Sameermd-18/industrial-paint-mixing-controller/hardware/system-overview.jpeg

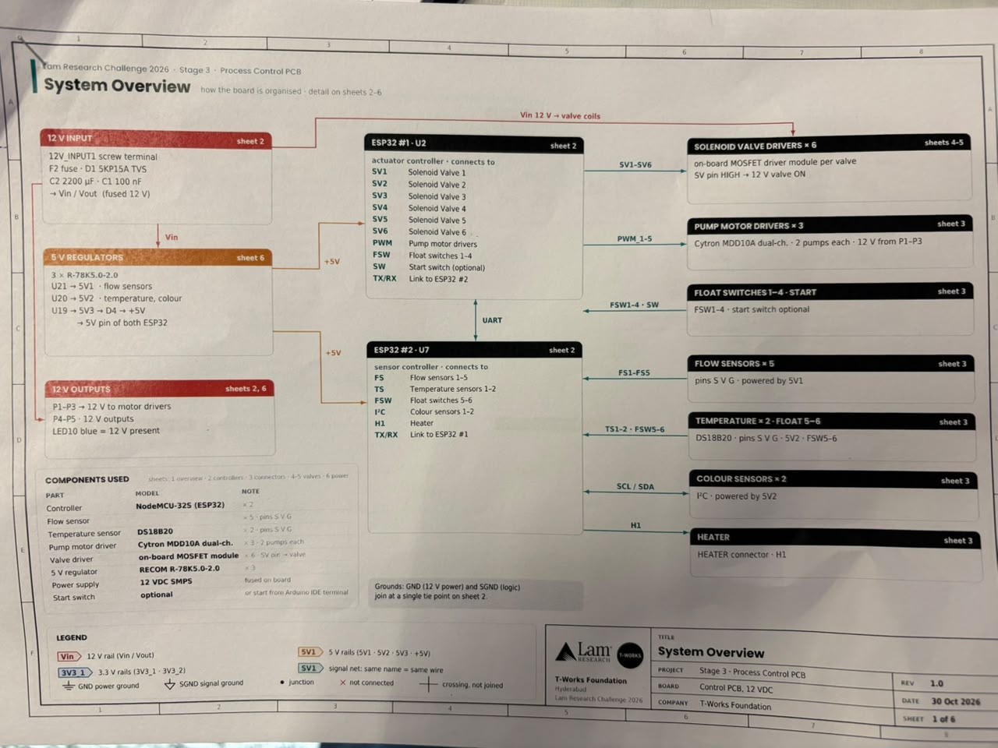
hardware/system-overview.jpeg
