Sameermd-18/industrial-paint-mixing-controller/hardware/solenoid-drivers.jpeg

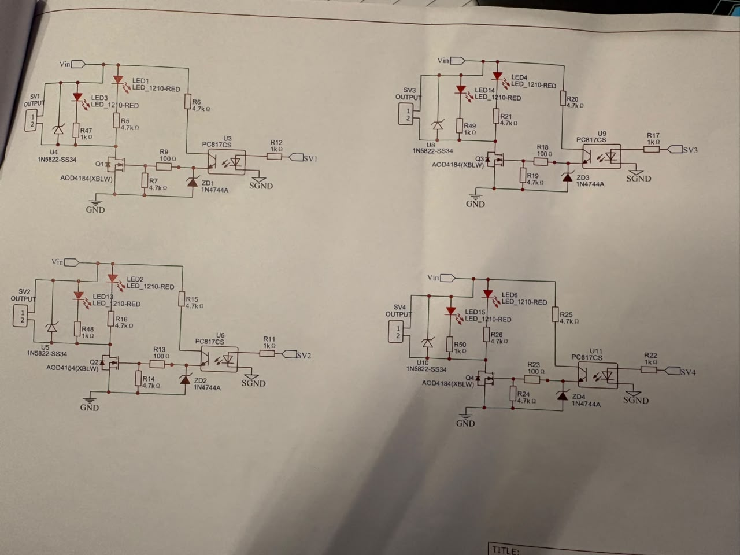
hardware/solenoid-drivers.jpeg
