Sameermd-18/industrial-paint-mixing-controller/hardware/README.md

# Hardware references

These are photographs of the supplied control PCB circuit schematics. They show the board architecture, ESP32 pin mapping, connector signals, and solenoid driver circuits. They are **not** fabrication-ready PCB layout files, Gerbers, or independently verified as-built wiring.

- [System overview](system-overview.jpeg)
- [ESP32 controller pins](esp32-controller-pins.jpeg)
- [Field connectors and flow sensor headers](field-connectors.jpeg)
- [Solenoid driver circuits, SV1–SV4](solenoid-drivers.jpeg)
- [ESP32 controllers and 12 V input (supplied sheet)](esp32-controllers-and-12v-input.jpeg)
- [Alternate controller schematic photograph](alternate-controller-schematic.jpeg)
- [Solenoid driver circuits, SV5–SV6](solenoid-drivers-sv5-sv6.jpeg)
- [5 V regulators and 12 V output connectors](power-regulators-and-12v-outputs.jpeg)
- [Sensor, motor driver, and switch connectors](sensor-and-motor-connectors.jpeg)

For the as-tested pump and valve mappings, use the top-level README and inspect the current U2/U7 sketches. The images are reference documentation only.
