Sameermd-18/industrial-paint-mixing-controller/hardware/alternate-controller-schematic.jpeg

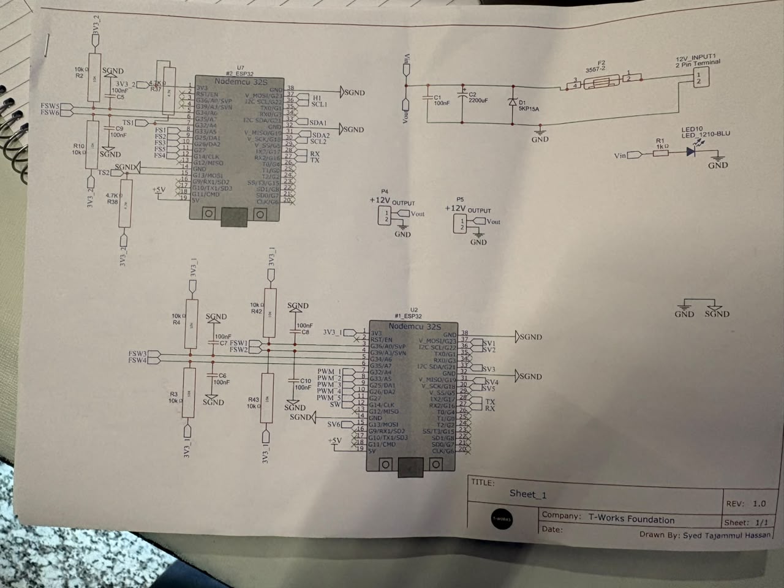
hardware/alternate-controller-schematic.jpeg
