Sameermd-18/industrial-paint-mixing-controller/hardware/esp32-controller-pins.jpeg

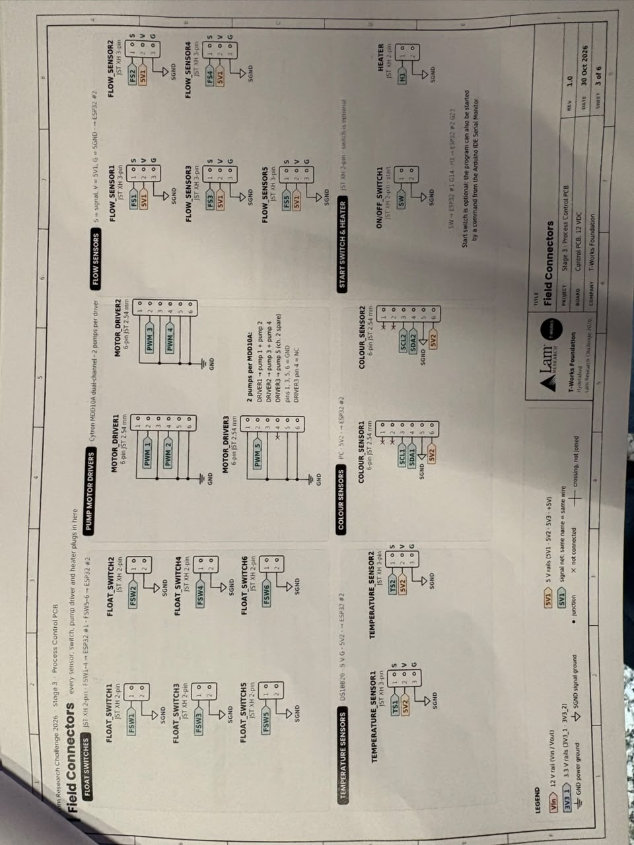
hardware/esp32-controller-pins.jpeg
