Sameermd-18/industrial-paint-mixing-controller/hardware/esp32-controllers-and-12v-input.jpeg

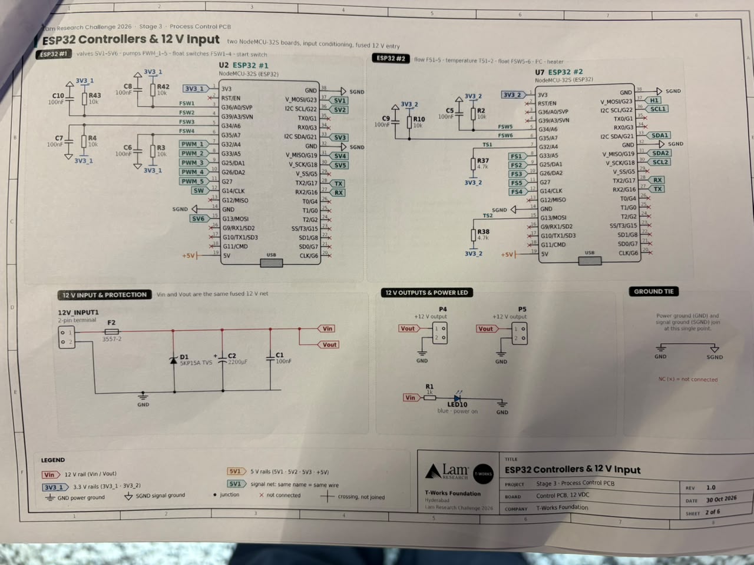
hardware/esp32-controllers-and-12v-input.jpeg
