Sameermd-18/industrial-paint-mixing-controller/hardware/field-connectors.jpeg

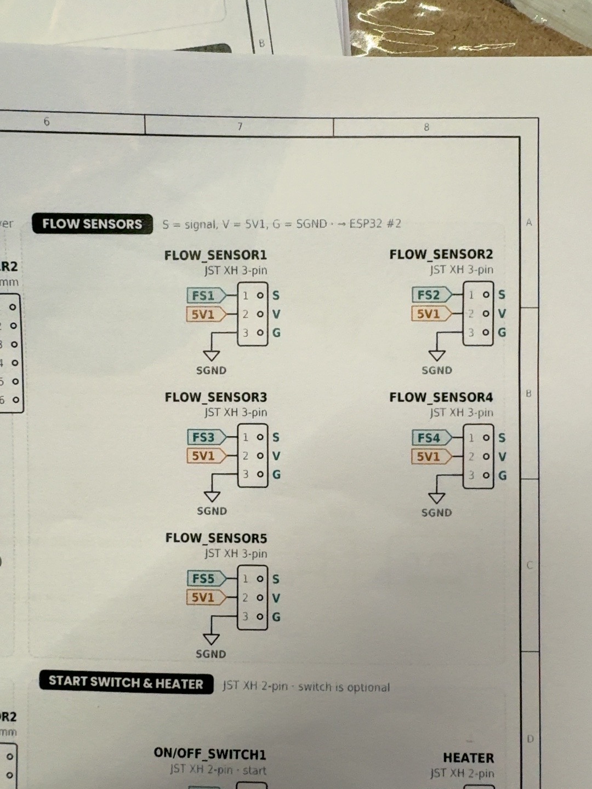
hardware/field-connectors.jpeg
