Sameermd-18/industrial-paint-mixing-controller/hardware/power-regulators-and-12v-outputs.jpeg

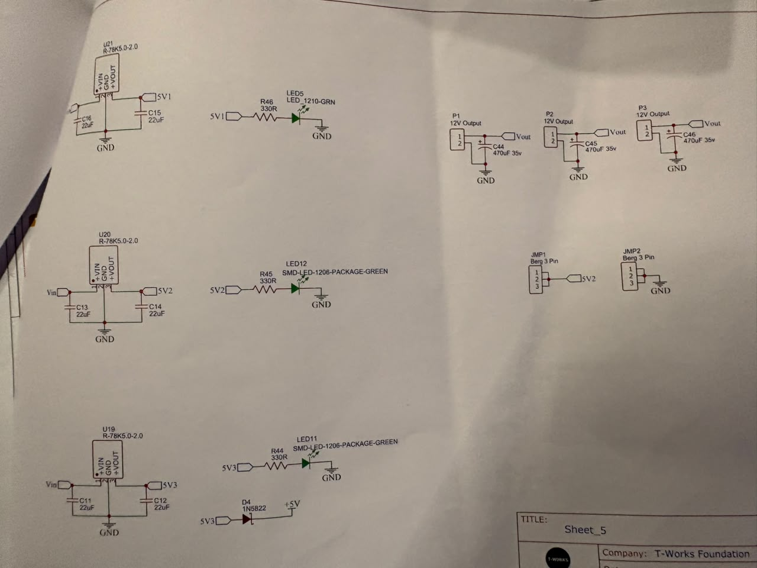
hardware/power-regulators-and-12v-outputs.jpeg
