Sameermd-18/industrial-paint-mixing-controller/hardware/sensor-and-motor-connectors.jpeg

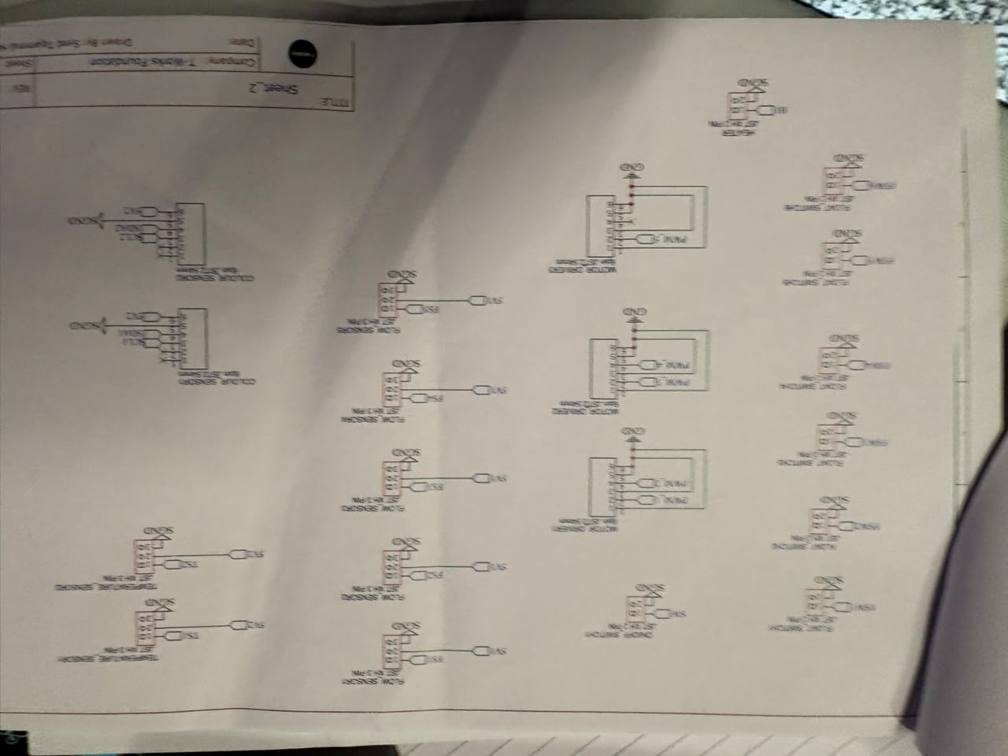
hardware/sensor-and-motor-connectors.jpeg
