Sameermd-18/industrial-paint-mixing-controller/hardware/solenoid-drivers-sv5-sv6.jpeg

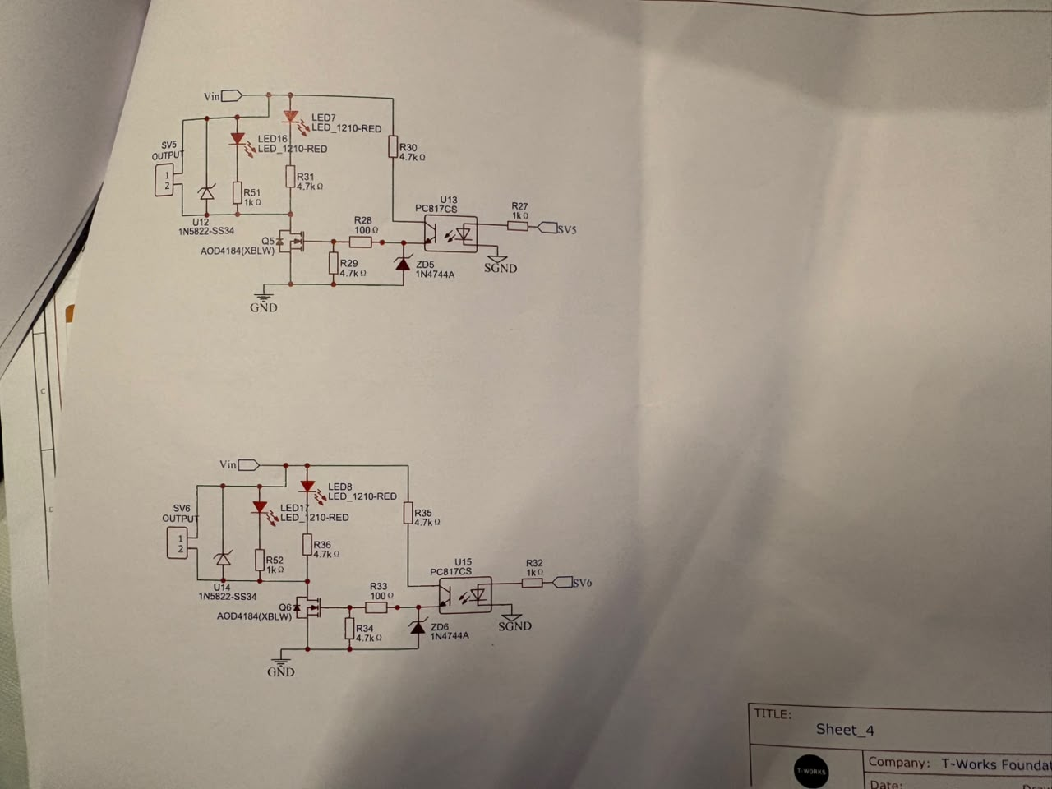
hardware/solenoid-drivers-sv5-sv6.jpeg
