Sameermd-18/industrial-paint-mixing-controller/(commit log)

2026-11-07 Add U7 flow and temperature telemetry firmware
2026-11-07 Describe supplied hardware schematic photos
2026-11-07 Add control PCB schematic reference photos
2026-11-07 Add standalone U7 temperature diagnostic
2026-11-07 Add standalone U7 flow pulse diagnostic
2026-11-07 Link schematic photos and standalone sensor diagnostics
2026-11-07 Add remaining PCB schematic sheets
2026-11-07 Index remaining PCB schematic sheets
